IOnishchenko/HFPowerAmplifier/(list of files, drawings)

Other design files:
LPF-SWR/control-interface.SchDoc
LPF-SWR/lpf-swr-srtucture.SchDoc
LPF-SWR/LPF-SWR.PcbDoc
LPF-SWR/LPF-SWR.PrjPcb
LPF-SWR/lpf.SchDoc
LPF-SWR/swr-antenna.SchDoc
PA-15-30W/control-interface.SchDoc
PA-15-30W/lpf.SchDoc
PA-15-30W/main.SchDoc
PA-15-30W/PA-15-30W-VAR2.PcbDoc
PA-15-30W/PA-15-30W.PcbDoc
PA-15-30W/PA-15-30W.PrjPcb
PA-15-30W/PA-15-30W.SchDoc
PA-15-30W/swr-antenna.SchDoc
PALib.PcbLib
PALib.SchLib
