IOnishchenko/HFPowerAmplifier/(commit log)

2022-11-06 HF Power Amplifier first commit.
    [PA-15-30W.PrjPcb, PA-15-30W.SchDoc, PALib.SchLib, control-interface.SchDoc, lpf.SchDoc, main.SchDoc, power-control.SchDoc, swr-tuner-antenna.SchDoc]
2022-11-06 HF Power Amplifier. PDF file was added.
2022-11-08 LPFs were added.
    [PA-15-30W.PrjPcb, PA-15-30W.SchDoc, PALib.SchLib, lpf.SchDoc, main.SchDoc, power-control.SchDoc, swr-antenna.SchDoc]
2022-11-12 PA-15-30W. Control interface was added.
    [PA-15-30W.PrjPcb, PA-15-30W.SchDoc, PALib.SchLib, control-interface.SchDoc, lpf.SchDoc, main.SchDoc, swr-antenna.SchDoc]
2022-11-12 PA-15-13W. SWR sensor was reworked to use tandem match.
    [PA-15-30W.PrjPcb, PA-15-30W.SchDoc, PALib.SchLib, lpf.SchDoc, swr-antenna.SchDoc]
2022-11-14 PA-15-30W. Some footprints were added.
    [PA-15-30W.PcbDoc, PA-15-30W.PrjPcb, PA-15-30W.SchDoc, PALib.PcbLib, PALib.SchLib, control-interface.SchDoc, lpf.SchDoc, swr-antenna.SchDoc]
2022-11-19 PA-15-30W. Footprints were added.
    [PA-15-30W.SchDoc, PALib.PcbLib, PALib.SchLib, control-interface.SchDoc, lpf.SchDoc, swr-antenna.SchDoc]
2022-11-19 PA-15-30W. Schematic diagrams are completed. The project is prepared to PCB designing.
    [PA-15-30W.PrjPcb, PA-15-30W.SchDoc, PALib.PcbLib, PALib.SchLib, control-interface.SchDoc, lpf.SchDoc, swr-antenna.SchDoc]
2022-11-24 PA-15-30W. LPF was reworked to place all components on board size 100x100 mm
    [LPF-SWR.PcbDoc, LPF-SWR.PrjPcb, PA-15-30W-VAR2.PcbDoc, PA-15-30W.PcbDoc, PA-15-30W.SchDoc, PALib.PcbLib, PALib.SchLib, control-interface.SchDoc]
2022-11-25 PA-15-30W. Components placement is done. Ready to tracing.
    [PALib.PcbLib, control-interface.SchDoc, lpf.SchDoc, swr-antenna.SchDoc]
2022-11-26 PA-15-30W. PCB tracing in progress.
    [PA-15-30W.PrjPcb, PA-15-30W.SchDoc, control-interface.SchDoc, lpf.SchDoc, swr-antenna.SchDoc]
2022-11-27 PA-15-30W. PCB designing. Components placement. The ground layers optimization.
    [PA-15-30W.PrjPcb, PALib.PcbLib]
2022-11-28 PA-15-30W. LPFs were reworked in order to optimaze GND layers.
    [PA-15-30W.PrjPcb, control-interface.SchDoc]
2022-11-29 PA-15-30W. Gerber files were added. Some order information were added to component descriptions.
    [PA-15-30W.PrjPcb, PA-15-30W.SchDoc, lpf.SchDoc]
2022-12-04 PA-15-30W. Additional information was added.
    [PA-15-30W.PrjPcb, PA-15-30W.SchDoc, control-interface.SchDoc, lpf.SchDoc, swr-antenna.SchDoc]
2023-01-02 PA-15-30W. Update some information.
    [PA-15-30W.PrjPcb, PA-15-30W.SchDoc]
